ian-dowell/Light-Sensor-Testing/CAD/Light Sensor Base.SLDPRT

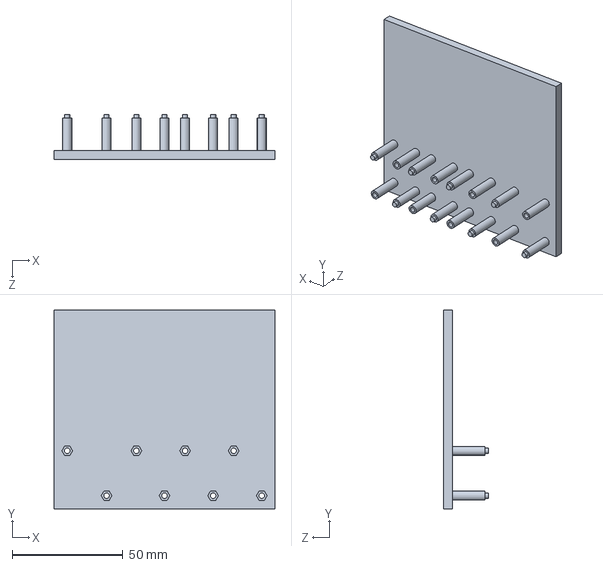
[picture p3: CAD file, 2026-10-19]
CAD/Light Sensor Base.SLDPRT
100.0 x 90.0 x 20.2 mm
