ian-dowell/Light-Sensor-Testing/(list of files, cad)

Other CAD files:
CAD/Light Sensor Base.STL
